JesusTapia-dev/PenduloInvertido-UNI/README.md

# Pendulo Invertido-UNI
Código para el seteo del motor brushless y del acelerómetro MPU9250, así como de los modelos 3D
# Calibración 
Mediante el cambio de los offsets se hace la calibración, se espera que después de un tiempo   los valores se acerquen a: 0 0 +16384 0 0 0 
ASAF
