JesusTapia-dev/PenduloInvertido-UNI/Archivos3D/README.md

En esta carpeta se encuentran los archivos para la impresión 3D de la rueda de reacción y del marco, son archivos de Autodesk Inventor(extension .ipt).
