JesusTapia-dev/PenduloInvertido-UNI/SimulacionMatlab/Readme.md

En esta sección veremos lo concerniente a la respuesta en el tiempo del controlador del paper Cubli
