JesusTapia-dev/PenduloInvertido-UNI/(list of files, cad)

Other CAD files:
Archivos3D/Frame.ipt
Archivos3D/Rueda_reaccion.ipt
